mribble/CameraAxe6/Pcb/CA6_boms/BeamDetect_gerber/BOM_beamDetect.xlsx

Ref Des | Part Description | Qty Used | Link
J1 | RJ45 | 1 | http://www.mouser.com/ProductDetail/Amphenol-Commercial-Products/RJHSE-5080/
U3 | TSOP 38 Khz IR receiver | 1 | https://www.mouser.com/ProductDetail/Vishay-Semiconductors/TSOP38238/
R1 | 100 Ohm 0603 Resistor 1% | 1 | http://www.mouser.com/ProductDetail/Susumu/RR0816P-102-D/
C1 | 100 uF Electrolitic Cap | 1 | http://www.mouser.com/ProductDetail/Panasonic/EEE-1CA101WP/
C2 | 0.1 uF 0603 Cap | 1 | https://www.mouser.com/ProductDetail/Wurth-Electronics/885012206071
