mribble/CameraAxe6/Pcb/CA6_boms/BeamDetect_gerber/quote for  W138057ASC25 T-C16W138057A-3sets-BOM_beamDetect 2019-1-18 - 副本(1).xlsx

Ref Des | Part Description | Qty Used | Link | provided part NO. | Remarks
J1 | RJ45 | 1 | http://www.mouser.com/ProductDetail/Amphenol-Commercial-Products/RJHSE-5080/ | RJHSE-5080 | 5-7work days
U3 | TSOP 38 Khz IR receiver | 1 | https://www.mouser.com/ProductDetail/Vishay-Semiconductors/TSOP38238/ | TSOP38238
R1 | 100 Ohm 0603 Resistor 1% | 1 | http://www.mouser.com/ProductDetail/Susumu/RR0816P-102-D/ | RR0816P-102-D | 5-7work days
C1 | 100 uF Electrolitic Cap | 1 | http://www.mouser.com/ProductDetail/Panasonic/EEE-1CA101WP/ | EEE-1CA101WP | 5-7work days
C2 | 0.1 uF 0603 Cap | 1 | https://www.mouser.com/ProductDetail/Wurth-Electronics/885012206071 | 885012206071
