mribble/CameraAxe6/Pcb/CA6_boms/BeamEmit_gerber/BOM_beamEmit.xlsx

Ref Des | Part Description | Qty Used | Link
J1 | RJ45 | 1 | http://www.mouser.com/ProductDetail/Amphenol-Commercial-Products/RJHSE-5080/
Q1 | Mosfet | 1 | http://www.mouser.com/Search/ProductDetail.aspx
D1 D2 | 950 nm IR LED 100 mA | 2 | https://www.mouser.com/ProductDetail/Vishay-Semiconductors/TSAL6100/
R2 | 100K Ohm 0603 Resistor 1% | 1 | https://www.mouser.com/ProductDetail/Susumu/RR0816P-101-D/
R4 | 1K Ohm 0603 Resistor 1% | 1 | http://www.mouser.com/ProductDetail/Susumu/RR0816P-102-D/
R1 | 4.7 Ohm 1206 0.25W Resistor 1% | 1 | https://www.mouser.com/ProductDetail/Yageo/RC1206JR-074R7L?qs=sGAEpiMZZMtG0KNrPCHnjTtiZEI2zSDgLEynvoDfNGg%3d
C1 | 100 uF Electrolitic Cap | 1 | http://www.mouser.com/ProductDetail/Panasonic/EEE-1CA101WP/
C3 | 10 uF 1206 Cap | 1 | https://www.mouser.com/ProductDetail/Taiyo-Yuden/TMK316BJ106KL-T
C2 | 0.1 uF 0603 Cap | 1 | https://www.mouser.com/ProductDetail/Wurth-Electronics/885012206071
