mribble/CameraAxe6/Pcb/CA6_boms/CA6_gerber/BOM_ca6.xlsx

Ref Des | Part Description | Qty Used | Link
U16 | ATSAM3X8EA-AU | 1 | http://www.mouser.com/ProductDetail/Atmel/ATSAM3X8EA-AU/?qs=sGAEpiMZZMtQuSbTnHsVtm6dgCW59dFS
U4 | ESP-12F Module (4M Flash version) | 1 | http://www.electrodragon.com/product/esp-12f-esp8266-wifi-board/
C14 C17 C20 C24 C25 | 20 pF 0603 Cap | 5 | http://www.mouser.com/ProductDetail/Murata-Electronics/GRM1885C1H200JA01D/
C10 C11 C12 C13 C15 C19 C21 C22 C29 C3 C34 C35 C38 C39 C4 C40 C41 C8 | 0.1 uF 0603 Cap | 18 | https://www.mouser.com/ProductDetail/Wurth-Electronics/885012206071
C1 C16 C18 C2 C27 C28 C30 C31 C32 C33 C37 C42 C5 C9 | 10 uF 1206 Cap | 14 | https://www.mouser.com/ProductDetail/Taiyo-Yuden/TMK316BJ106KL-T
C23 C26 C6 C7 | 100 uF Electrolitic Cap | 4 | http://www.mouser.com/ProductDetail/Panasonic/EEE-1CA101WP/
R26 R27 | 39 Ohm 0603 Resistor 1% | 2 | http://www.mouser.com/ProductDetail/Susumu/RR0816Q-390-D/
R22 R23 R24 R30 R33 R34 R37 R38 R41 R42 R45 R46 R49 R50 R53 R54 R57 R58 | 274 Ohm 0603 Resistor 1% | 18 | https://www.mouser.com/ProductDetail/Yageo/RT0603FRE07274RL
R31 R32 R35 R36 R39 R40 R43 R44 R47 R48 R51 R52 R55 R56 R59 R60 | 680 Ohm 0603 Resistor 1% | 16 | http://www.mouser.com/ProductDetail/Susumu/RR0816P-681-D/
R62 R65 | 4k7 Ohm 0603 Resistor 1% | 2 | http://www.mouser.com/ProductDetail/Susumu/RR0816P-472-D/
R28 | 6K8 Ohm 0603 Resistor 1% | 1 | http://mouser.com/ProductDetail/Susumu/RR0816P-682-D/
R1 R10 R11 R12 R13 R14 R15 R16 R2 R21 R3 R4 R5 R6 R61 R63 R64 R66 R7 R8 R9 | 10K Ohm 0603 Resistor 1% | 21 | http://www.mouser.com/ProductDetail/Susumu/RR0816P-103-D/
R29 | 30K ohm 0603 Resistor 1% | 1 | http://www.mouser.com/ProductDetail/Susumu/RR0816P-303-D/
R17 R18 R19 R20 R25 | 100K Ohm 0603 Resistor 1% | 5 | http://www.mouser.com/ProductDetail/Susumu/RR0816P-104-D/
X7 | 12 Mhz Crystal | 1 | http://www.mouser.com/ProductDetail/ABRACON/ABM3B-12000MHZ-B2-T/
X8 | 32.786 KHz Crystal | 1 | http://www.mouser.com/ProductDetail/ABRACON/AB26TRQ-32768kHz-T/
VR1 VR2 VR3 | Varistor 0603 | 3 | http://www.mouser.com/ProductDetail/Bourns/CG0603MLC-05E/
F1 | resetable fuses 1812 (perfer 1.0 A hold, but 1.1A is ok) | 1 | http://www.mouser.com/ProductDetail/Littelfuse/MINISMDC110F-24-2/
FB1 FB2 FB3 | EMI Filter Beads 805 | 3 | http://www.mouser.com/ProductDetail/Bourns/MH2029-601Y/
D1 D2 D3 D4 D5 D6 D7 D8 D9 | Red/Green LED | 9 | http://www.mouser.com/ProductDetail/Kingbright/AM23ESGC/
SW4 | Through Hole Tactile Button | 1 | http://www.mouser.com/ProductDetail/CK-Components/PTS645SL70-2-LFS/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
SW1 SW3 | SMD Tactile Button PTS645 Series | 2 | https://www.mouser.com/Search/ProductDetail.aspx
SW2 | on/off switch 1A | 1 | http://www.mouser.com/ProductDetail/E-Switch/EG1224/
J1 | Micro USB type B | 1 | http://www.mouser.com/ProductDetail/FCI/10118194-0001LF/
CAM0 CAM1 CAM2 CAM3 CAM4 CAM5 CAM6 CAM7 | 3.5 mm jack (Camera Ports) (SJ-3523) | 8 | http://www.mouser.com/ProductDetail/CUI/SJ-3523-SMT-TR/
J2 | 2 3.5mm Screw Terminal | 1 | http://www.mouser.com/ProductDetail/Phoenix-Contact/1984617/
J3 J5 J4 J8 | RJ45 Module Socket | 4 | http://www.mouser.com/ProductDetail/Amphenol-Commercial-Products/RJHSE-5080/
J6 | 90 degree Expansion Port 50 PIN (2X25) | 1 | https://www.mouser.com/ProductDetail/3M-Electronic-Solutions-Division/30350-5002HB
Q1 Q10 Q11 Q12 Q13 Q14 Q15 Q16 Q2 Q3 Q4 Q5 Q6 Q7 Q8 Q9 | BSS138 Mosfet (Cam Ports) | 16 | http://www.mouser.com/ProductDetail/NXP-Semiconductors/BSS138P215/
P1 | jtag conector | 1 | http://www.mouser.com/Search/ProductDetail.aspx
U12 | 3.3V LDO Reg | 1 | http://www.mouser.com/ProductDetail/Texas-Instruments/LP38692MP-33-NOPB/?qs=sGAEpiMZZMvu8NZDyZ4K0c0kBHVNK554
U3 | 74AHC Buffer Chip | 2 | https://www.mouser.com/ProductDetail/Texas-Instruments/SN74LVC244APWR/
P3 | FTDI 6 Pin Header | 1 | http://www.mouser.com/ProductDetail/Molex/22-28-4060/
U1 U2 | 74AHC Logic-and | 1 | http://www.mouser.com/ProductDetail/Texas-Instruments/SN74AHC1G08DBVR/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
