mribble/CameraAxe6/Pcb/CA6_boms/Dev_gerber/BOM_dev.xlsx

Ref Des | Part Description | Qty Used | Link
J2 | RJ45 | 1 | http://www.mouser.com/ProductDetail/Amphenol-Commercial-Products/RJHSE-5080/
C1 | 10 uF 1206 Cap | 1 | https://www.mouser.com/ProductDetail/Taiyo-Yuden/TMK316BJ106KL-T
J1 | 3.5 mm jack (Camera Ports) (SJ-3523) | 1 | http://www.mouser.com/ProductDetail/CUI/SJ-3523-SMT-TR/
SW0 | SMD push switch | 1 | http://www.mouser.com/ProductDetail/CK-Components/PTS645SM43SMTR-92-LFS/
