mribble/CameraAxe6/Pcb/CA6_boms/Dev_gerber/quote for W138057ASC26-5sets-BOM_dev   2019-1-21.xlsx

Ref Des | Part Description | Qty Used | Link | provided part NO. | Remarks
J2 | RJ45 | 1 | http://www.mouser.com/ProductDetail/Amphenol-Commercial-Products/RJHSE-5080/ | RJHSE-5080 | 5-7work days
C1 | 10 uF 1206 Cap | 1 | https://www.mouser.com/ProductDetail/Taiyo-Yuden/TMK316BJ106KL-T | TMK316BJ106KL-T
J1 | 3.5 mm jack (Camera Ports) (SJ-3523) | 1 | http://www.mouser.com/ProductDetail/CUI/SJ-3523-SMT-TR/ | SJ-3523-SMT-TR | 5-7work days
SW0 | SMD push switch | 1 | http://www.mouser.com/ProductDetail/CK-Components/PTS645SM43SMTR-92-LFS/ | PTS645SM43SMTR92LFS | 5024pcs in stock
