mribble/CameraAxe6/Pcb/CA6_boms/Light_gerber/BOM_light.xlsx

Ref Des | Part Description | Qty Used | Link
J1 | RJ45 | 1 | http://www.mouser.com/ProductDetail/Amphenol-Commercial-Products/RJHSE-5080/
C2 | 100 uF Electrolitic Cap | 1 | http://www.mouser.com/ProductDetail/Panasonic/EEE-1CA101WP/
C1 | 10 uF 1206 Cap | 1 | https://www.mouser.com/ProductDetail/Taiyo-Yuden/TMK316BJ106KL-T
R3 | 160 Ohm 1206 Resistor 1/4W 1% | 1 | https://www.mouser.com/ProductDetail/Yageo/RT1206FRE07160RL/
R4 R2 R1 | 1K Ohm 0603 Resistor 1% | 3 | http://www.mouser.com/ProductDetail/Susumu/RR0816P-102-D/
R6 | 10K Ohm 0603 Resistor 1% | 1 | http://www.mouser.com/ProductDetail/Susumu/RR0816P-103-D/
R5 | 3.9k Ohm 0603 Resistor 1% | 1 | https://www.mouser.com/productdetail/susumu/rr0816p-392-d
R7 | 15k Ohm 0603 Resistor 1% | 1 | https://www.mouser.com/productdetail/susumu/rr0816p-153-d
U1 U2 U3 | SN74LVC1G07 Single Buffer/Driver | 3 | https://www.mouser.com/ProductDetail/Texas-Instruments/SN74LVC1G07DCKR/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
Q2 | Mosfet | 1 | http://www.mouser.com/Search/ProductDetail.aspx
J2 | 3.5 mm jack (Camera Ports) (SJ-3523) | 1 | http://www.mouser.com/ProductDetail/CUI/SJ-3523-SMT-TR/
