mribble/CameraAxe6/Pcb/CA6_boms/Light_gerber/quote for W138057ASC24-T-C19W138057A-5sets-BOM_light 2019-1-18 - 副本.xlsx

Ref Des | Part Description | Qty Used | Link | provided part NO. | Remarks
J1 | RJ45 | 1 | http://www.mouser.com/ProductDetail/Amphenol-Commercial-Products/RJHSE-5080/ | RJHSE-5080 | 5-7work days
C2 | 100 uF Electrolitic Cap | 1 | http://www.mouser.com/ProductDetail/Panasonic/EEE-1CA101WP/ | EEE-1CA101WP | 5-7work days
C1 | 10 uF 1206 Cap | 1 | https://www.mouser.com/ProductDetail/Taiyo-Yuden/TMK316BJ106KL-T | TMK316BJ106KL-T
R3 | 160 Ohm 1206 Resistor 1/4W 1% | 1 | https://www.mouser.com/ProductDetail/Yageo/RT1206FRE07160RL/ | RT1206FRE07160RL
R4 R2 R1 | 1K Ohm 0603 Resistor 1% | 3 | http://www.mouser.com/ProductDetail/Susumu/RR0816P-102-D/ | RR0816P-102-D | 5-7work days
R6 | 10K Ohm 0603 Resistor 1% | 1 | http://www.mouser.com/ProductDetail/Susumu/RR0816P-103-D/ | RR0816P-103-D | 5-7work days
R5 | 3.9k Ohm 0603 Resistor 1% | 1 | https://www.mouser.com/productdetail/susumu/rr0816p-392-d | RR0816P-392-D | 5-7work days
R7 | 15k Ohm 0603 Resistor 1% | 1 | https://www.mouser.com/productdetail/susumu/rr0816p-153-d | RR0816P-153-D | 5-7work days
U1 U2 U3 | SN74LVC1G07 Single Buffer/Driver | 3 | https://www.mouser.com/ProductDetail/Texas-Instruments/SN74LVC1G07DCKR/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 | SN74LVC1G07DCKR
Q2 | Mosfet | 1 | http://www.mouser.com/Search/ProductDetail.aspx | IRLML6244TRPBF
J2 | 3.5 mm jack (Camera Ports) (SJ-3523) | 1 | http://www.mouser.com/ProductDetail/CUI/SJ-3523-SMT-TR/ | SJ-3523-SMT-TR | 5-7work days
