mribble/CameraAxe6/Pcb/CA6_boms/Projectile_gerber/BOM_projectile.xlsx

Ref Des | Part Description | Qty Used | Link
J1 | RJ45 | 1 | http://www.mouser.com/ProductDetail/Amphenol-Commercial-Products/RJHSE-5080/
D2 D3 D4 D5 | 890 nm IR LED 100 mA | 4 | https://www.mouser.com/ProductDetail/Vishay-Semiconductors/TSHF5210/
Q1 Q2 | Mosfet | 2 | http://www.mouser.com/Search/ProductDetail.aspx
D1 D6 | IR Diode SFH213 FA | 2 | https://www.mouser.com/ProductDetail/OSRAM-Opto-Semiconductors/SFH-213-FA/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
U1 U2 | Opamp | 2 | https://www.mouser.com/ProductDetail/Texas-Instruments/OPA320AIDBVR/?qs=sGAEpiMZZMv2WiXdFcmpiKWA4h8Ns2XN
C4 C6 | 4.3 pF Cap C0G (NP0) 0805 | 2 | https://www.mouser.com/ProductDetail/AVX/08055A4R3DAQ2A/?qs=sGAEpiMZZMs0AnBnWHyRQKdiqyDPVQdAb6zdUloBn8k%3d
C2 | 0.1 uF 0603 Cap | 1 | https://www.mouser.com/ProductDetail/Wurth-Electronics/885012206071
C3 C5 | 1 uF 0603 Cap | 2 | https://www.mouser.com/ProductDetail/Wurth-Electronics/885012106022
C2 | 10 uF 1206 Cap | 1 | https://www.mouser.com/ProductDetail/Taiyo-Yuden/TMK316BJ106KL-T
R3 R11 | 280 Ohm 0603 Resistor 1% | 2 | https://www.mouser.com/ProductDetail/Yageo/RT0603DRD07280RL/
R5 R12 | 8980 Ohm 0603 Resistor 1% | 2 | https://www.mouser.com/ProductDetail/KOA-Speer/RN731JTTD8981D25/
R1 R2 R6 R8 R9 R10 | 49.9 ohm 0603 Resistor 1% | 6 | https://www.mouser.com/ProductDetail/Susumu/RR0816Q-49R9-D-68R/
R4 R16 | 1K Ohm 0603 Resistor 1% | 2 | http://www.mouser.com/ProductDetail/Susumu/RR0816P-102-D/
R14 R15 | 10K Ohm 0603 Resistor 1% | 2 | http://www.mouser.com/ProductDetail/Susumu/RR0816P-103-D/
R7 R13 | 100K Ohm 0603 Resistor 1% | 2 | https://www.mouser.com/ProductDetail/Susumu/RR0816P-101-D/
