mribble/CameraAxe6/Pcb/CA6_boms/Sound_gerber/BOM_sound.xlsx

Ref Des | Part Description | Qty Used | Link
J1 | RJ45 | 1 | http://www.mouser.com/ProductDetail/Amphenol-Commercial-Products/RJHSE-5080/
MK1 | Microphone Condenser | 1 | http://www.mouser.com/ProductDetail/CUI-Inc/CMA-4544PF-W/
U1 | Max 4466 Op Amp | 1 | http://www.mouser.com/ProductDetail/Maxim-Integrated/MAX4466EXK+T/?qs=sGAEpiMZZMuuBt6TL7D%2f6Dhq2AfIYa6Q
C4 | 47 pF 0603 Cap | 1 | http://www.mouser.com/ProductDetail/KEMET/C0603C470J1GACAUTO/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
C3 | 0.1 uF 0603 Cap | 1 | https://www.mouser.com/ProductDetail/Wurth-Electronics/885012206071
C2 | 1 uF 0603 Cap | 1 | https://www.mouser.com/ProductDetail/Wurth-Electronics/885012106022
C5 C1 | 47 uF 1206 Cap | 2 | http://www.mouser.com/ProductDetail/Taiyo-Yuden/LMK316BJ476ML-T/
R1 | 1K Ohm 0603 Resistor 1% | 1 | http://www.mouser.com/ProductDetail/Susumu/RR0816P-102-D/
R2 | 2.2K Ohm 0603 Resistor 1% | 1 | http://www.mouser.com/ProductDetail/Susumu/RR0816P-222-D/
R5 | 20K Ohm 0603 Resistor 1% | 1 | http://www.mouser.com/ProductDetail/Susumu/RR0816P-203-D/
R3 R4 | 100K Ohm 0603 Resistor 0.1% | 2 | http://www.mouser.com/ProductDetail/Panasonic/ERA-3AEB104V/?qs=sGAEpiMZZMu61qfTUdNhGxEjuuBLd0B4thhjUDN4FtU%3d
R6 | 1M Ohm 0603 Resistor 1% | 1 | http://www.mouser.com/ProductDetail/TE-Connectivity-Neohm/CPF0603B1M0E1/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
