mribble/CameraAxe6/Pcb/CA6_boms/Valve_gerber/BOM_valve.xlsx

Ref Des | Part Description | Qty Used | Link
J1 | RJ45 | 1 | http://www.mouser.com/ProductDetail/Amphenol-Commercial-Products/RJHSE-5080/
Q1 Q2 Q3 Q4 | Motor Mosfet | 4 | http://www.mouser.com/Search/ProductDetail.aspx
D1 D2 D3 D4 | Diode | 4 | http://www.mouser.com/ProductDetail/Vishay-Semiconductors/S07G-GS08/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
C1 | 10 uF 1206 Cap | 1 | https://www.mouser.com/ProductDetail/Taiyo-Yuden/TMK316BJ106KL-T
C2 | 100 uF Electrolitic Cap | 1 | http://www.mouser.com/ProductDetail/Panasonic/EEE-1CA101WP/
Servo1 Servo2 | Servo Terminal | 2 | http://www.mouser.com/ProductDetail/FCI/68016-403HLF/
POWER1 | DC Jack 2.1 x 5.51 mm (Power) | 1 | http://www.digikey.com/product-detail/en/PJ-002A/CP-002A-ND/96962
Valve1 Valve2 Valve3 Valve4 | DC Jack 1.3 x 3.5 mm (Valves) | 4 | http://www.mouser.com/ProductDetail/CUI/PJ-017DH/
R1 R3 R5 R7 R9 | 1K Ohm 0603 Resistor 1% | 5 | http://www.mouser.com/ProductDetail/Susumu/RR0816P-102-D/
R2 R4 R6 R8 | 10K Ohm 0603 Resistor 1% | 4 | http://www.mouser.com/ProductDetail/Susumu/RR0816P-103-D/
D5 | Green LED 0805 | 1 | https://www.mouser.com/ProductDetail/OSRAM-Opto-Semiconductors/LG-R971
