mribble/CameraAxe6/Pcb/CA6_boms/Vibration_gerber/quote for W138057ASC30-5sets-BOM_vibration 2019-1-20.xlsx

Part Description | Ref Des | Part Description | Qty Used | Link | provided part NO. | Remarks
RJ45 | J1 | RJ45 | 1 | http://www.mouser.com/ProductDetail/Amphenol-Commercial-Products/RJHSE-5080/ | RJHSE-5080 | 5-7work days
1M Ohm 0603 Resistor | R1 | 0603 1M Ohm Resistor | 1 | http://www.mouser.com/ProductDetail/Bourns/CRT0603-DZ-1004ELF/ | CRT0603-DZ-1004ELF | 5-7work days
Zener Diode sot23 | D1 | 3.3V Zener Diode | 1 | http://www.mouser.com/ProductDetail/Rectron/BZX84C3V3-T1/ | BZX84C3V3-T1 | 5-7work days
