mribble/CameraAxe6/Case/module_plate v15.stl

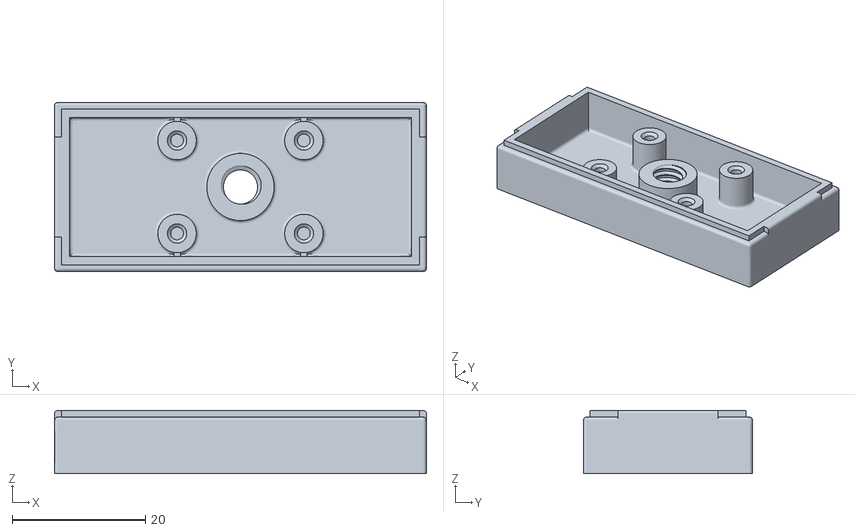
[picture p1: CAD file, 2019-04-10]
Case/module_plate v15.stl
55.9 x 25.4 x 9.50
