mribble/CameraAxe6/Case/module_plate_top v8.stl

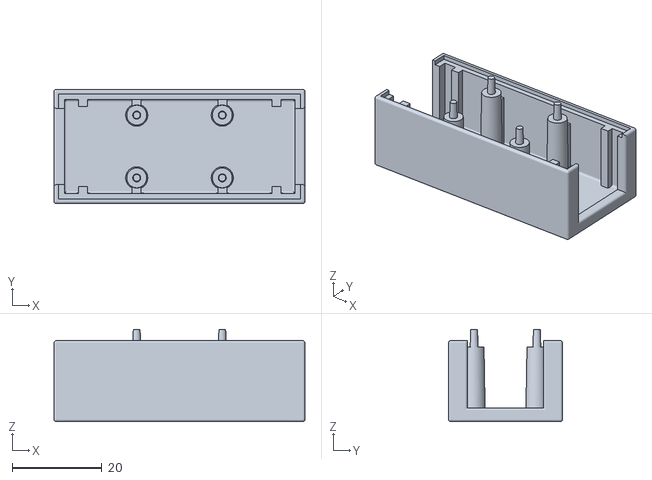
[picture p2: CAD file, 2019-04-10]
Case/module_plate_top v8.stl
55.9 x 25.4 x 20.5
