mribble/CameraAxe6/Case/Battery Cover v11.stl

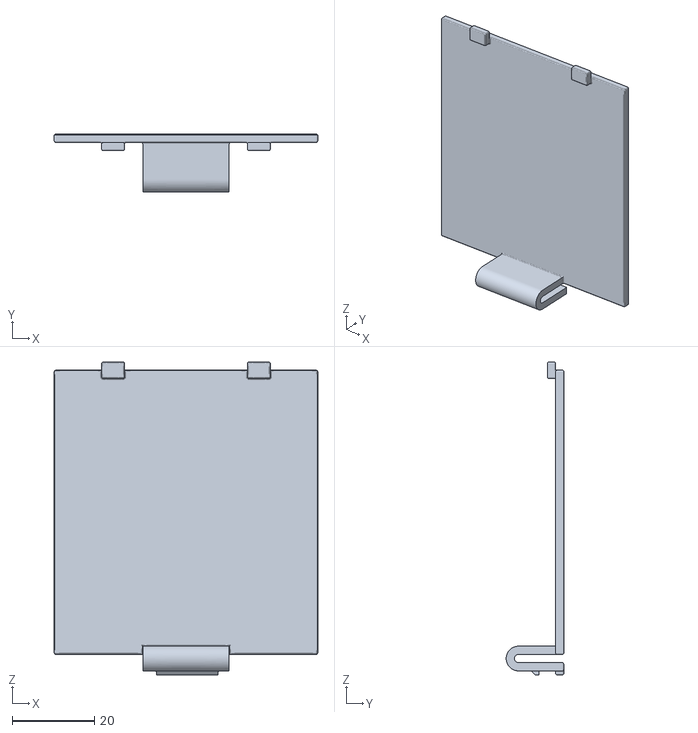
[picture p3: CAD file, 2019-04-10]
Case/Battery Cover v11.stl
64.0 x 14.0 x 76.0
