mribble/CameraAxe6/Case/Battery Cover Tight Fit v2.stl

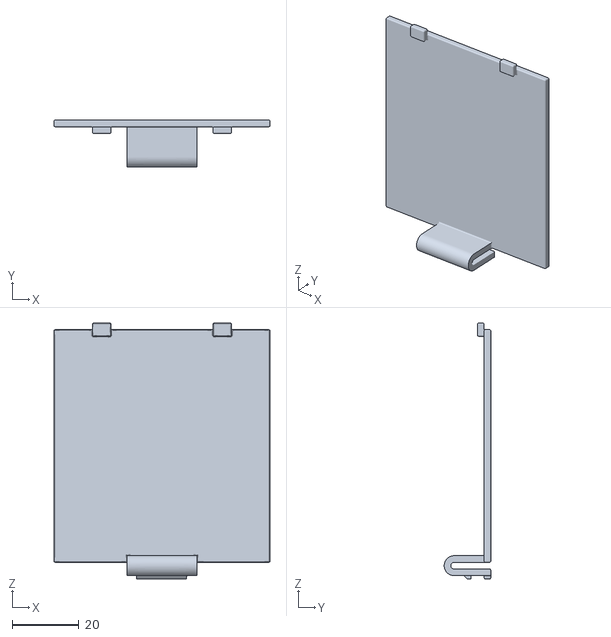
[picture p4: CAD file, 2019-04-10]
Case/Battery Cover Tight Fit v2.stl
64.8 x 14.0 x 76.8
