mribble/CameraAxe6/Case/CA6 Top Half.stl

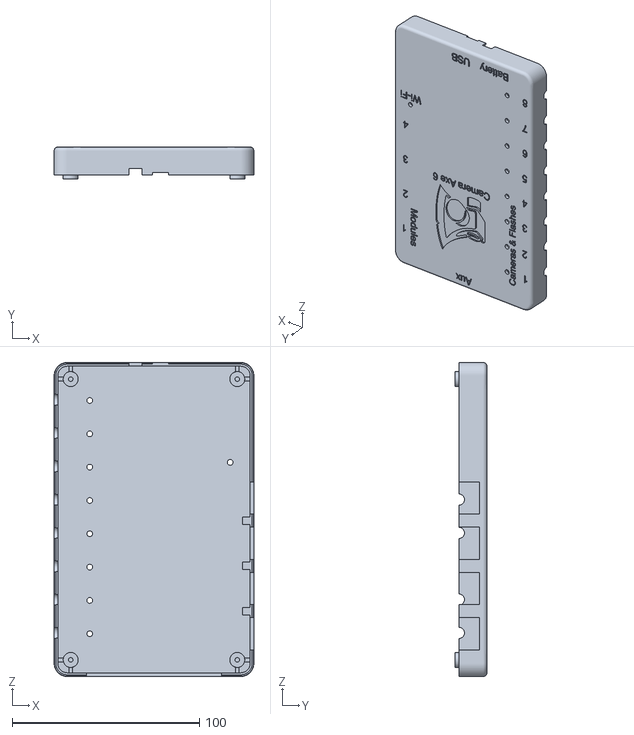
[picture p5: CAD file, 2019-04-10]
Case/CA6 Top Half.stl
106.6 x 17.0 x 167.6
