mribble/CameraAxe6/Case/CA6 Bottom Half.stl

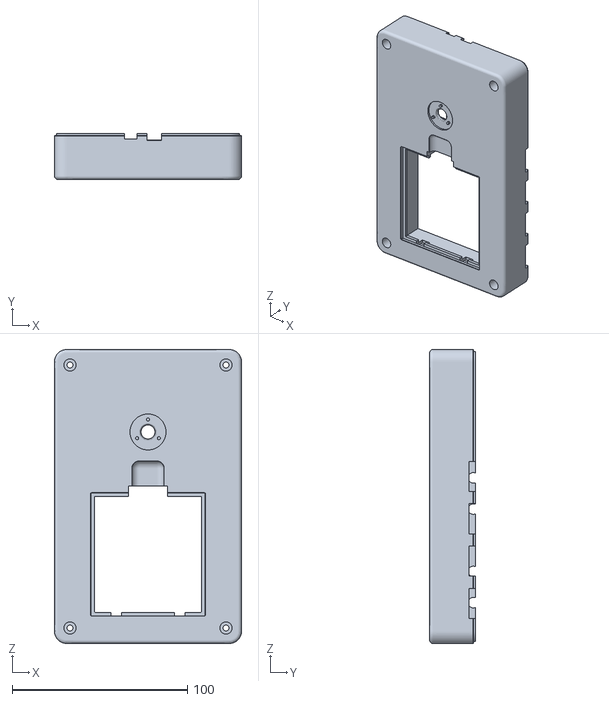
[picture p6: CAD file, 2019-04-10]
Case/CA6 Bottom Half.stl
106.6 x 26.2 x 167.6
