mribble/CameraAxe6/CameraAxeFlash/Spice/CameraAxeFlash.asc

A1: and; Vhigh=5
A2: srflop; Vhigh=5, ic=0, Ref=2.5, Td=10n
B1: bv; V=if(V(VT0)<2.9, 5, 0) ; V Limit
B2: bv; V=if(I(R3)<0.1, 5, 0) ; Flux Reset
B3: bv; V=if(I(R3)>2, 5, 0) ; Max I current
C1: polcap; 10µ; V=250 Rser=100m Lser=0
C2: cap; 0.1µ
C3: cap; 0.1µ
C4: cap; 0.1µ
D1: schottky; RB058L150
D2: LED; CMA255072WHT
D3: LED; MH-BWHT
L1: ind; 100µ; Ipk=3 Rser=180m Rpar=0 Cpar=0
L2: ind; 20n
M1: nmos; IRFP250N
M2: nmos; irfs4227pbf
R1: res; 1Meg
R2: res; 20K
R3: res; 1
R4: res; 100
R5: res; 10K
V1: voltage; 12
V2: voltage; PULSE(0 12 .12 0 0 50u)
V3: voltage; PULSE(0 5 0 0 0 18u 58u)
Named nets: 0, VT0
.tran 0 .15 0
C1 scaled /10
to reduce simulation time
Voltage logic, and gate, and flipflop all simulated by microcontroller
.lib CMA3090-72VSpice.txt
.lib irfs4227pbf.spi
.lib TC4420_I2D_B.mod
.lib XLamp-MHB-Spice.txt
