mribble/CameraAxe6/(list of files, drawings)

Other design files:
Pcb/CA6.dsn
Pcb/Cards/ESP8266card.dsn
Pcb/Cards/nRF52card.dsn
Pcb/Modules/Dev/Dev.dsn
Pcb/Modules/Sound/Sound.dsn
Pcb/Modules/Valve/Valve.dsn
