mribble/CameraAxe6/Sam3x/CA6/CA6.ino

////////////////////////////////////////////////////////////////////////////////////////////////////////////////////////
// Maurice Ribble
// Dreaming Robots - Copyright 2017, 2018
//
// This runs the Camera Axe 6 (CA6) software on an sam3x microcontroller.  The primary purposes of this software are
// to communicate with the esp8266 wifi module, monitor modules, and trigger cameras/flashes as requested.
//
// 2018.1.18
//   - Initial version
////////////////////////////////////////////////////////////////////////////////////////////////////////////////////////

#include <CAPacket.h>
#include <CAPacketHelper.h>
#include <CAEsp8266.h>
#include "Context.h"
#include "Menus.h"
#include "NewMenu.h"
#include "PacketProcessor.h"
#include "Terminal.h"
#include "Tests.h"
#include "TriggerCam.h"

// Global Context
Context g_ctx;
String gSamVersion = "sam180721";

void setup() {
  // Set up clock ticks
  *REG_SCB_DEMCR |= 0x01000000;
  *REG_DWT_CTRL |= (uint32_t)1;
  *REG_DWT_CYCCNT = (uint32_t)0;

  // When CC_EXT0 is high it forces the esp8266 into test mode
  hwPortPin ppExt0 = CAU::getOnboardDevicePin(CC_EXT0);
  CAU::pinMode(ppExt0, OUTPUT);
  CAU::digitalWrite(ppExt0, LOW);

  initCameraPins();
  SerialIO.begin(12345); // Speed doesn't matter here
  CAU::initializeAnalog();
  g_ctx.esp8266.init(74880);
  g_ctx.packetHelper.init(g_ctx.esp8266.getSerial(), (HardwareSerial*)(&SerialIO));
  hwPortPin ppVoltage = CAU::getOnboardDevicePin(LV_DETECT_PIN);
  CAU::pinMode(ppVoltage, ANALOG_INPUT);
  caRunTests();
  esp8266ProgramMode();
}

void loop() {
  uint32_t periodDataTime = 0;
  while(1) { // Existing loop causes 10 ms delay so we will stay in it forever to avoid that delay
    processTerminalCmds();

    if (g_ctx.state == CA_STATE_MENU_MODE) {
      if (g_ctx.menuId == 0) {
        // Menus normally process packets, but menuId is a null menu which means we need to handle the processing here
        CAPacketElement *packet = processIncomingPacket();
        if (packet) {
          delete packet;
        }
      } else {
        g_ctx.procTable.funcMenuRun[g_ctx.menuId]();
      }
      if (!camTriggerRunning()) {
        // This needs to get turned off for test trigger and there wasn't a better spot
        resetCameraPorts();
      }
      if ((millis() - periodDataTime) >= 20000) {  // Send periodic data every 20 seconds
        g_ctx.packetHelper.writePacketPeriodicData(getHundredthsOfVoltsAtBattery(), gSamVersion.c_str());
        periodDataTime = millis();
      }
    } else if (g_ctx.state == CA_STATE_PHOTO_MODE) {
      g_ctx.procTable.funcPhotoRun[g_ctx.menuId]();
    } else {
      CA_ASSERT(0, "Unsupported CA_STATE mode");
    }
  }
}

// Get the current voltage
uint32_t getHundredthsOfVoltsAtBattery() {
  hwPortPin ppVoltage = CAU::getOnboardDevicePin(LV_DETECT_PIN);
  uint32_t voltage = CAU::analogRead(ppVoltage);
  // Convert to hundredths of volts by multiplying by max max voltage (4096 is from 12 bit ADC on sam3x)
  // (3.3 * 4 * 100)=1320 [3.3 is voltage; 4x voltage divider circuit; 100 is to make hundredths of volts]
  voltage = voltage * 1320 / 4096;
  return voltage;  
}

// Put esp8266 into programming mode if dev module on port 4 button pressed during boot
void esp8266ProgramMode() {
  hwPortPin ppPin;
  ppPin = CAU::getOnboardDevicePin(PROG_BUTTON);
  CAU::pinMode(ppPin, INPUT_PULLUP);
  if (CAU::digitalRead(ppPin) == LOW) {
    CA_LOG(CA_INFO, "Sam3x passthrough ESP8266 reprogramming mode, cycle power when finished\n");
    g_ctx.esp8266.end();
    g_ctx.esp8266.init(115200);
    g_ctx.esp8266.reprogramESP();
    g_ctx.packetHelper.flushGarbagePackets();
    blinkCameraPins();

    HardwareSerial *s = g_ctx.esp8266.getSerial();
    // Setup serial passthrough.  Must use power switch after programming is complete
    while (1) {
      if(SerialIO.available()){
        s->write(SerialIO.read());
      }
      if(s->available()){
        SerialIO.write(s->read());
      }
    }
  }
}
