mribble/CameraAxe6/(commit log)

2017-01-03 Fix some bugs in packet code and clean up tests
    [Tests.ino]
2017-01-04 A bug in the tests were hiding several bugs in the packet classes. Fixed all known bugs in this code.
    [Tests.ino]
2017-01-04 Add button packet. Previously the button didn't have any text so that was added.
    [Tests.ino]
2017-01-05 Add DROP_SELECT packet. Also realized I was forgetting to copy over the lib changes for the past serveral commits so the builds were broken. This should fix that.
    [Tests.ino]
2017-01-07 Add Button and CheckBox packets to Android
2017-01-09 Update module and camera code to use new packet data. (More work needed)
2017-01-12 Add packet reset and a packet handler on the sam3x side
    [CA6.ino, Context.h, PacketProcessor.ino, Tests.ino]
2017-01-12 Change ACTIVATE packet to MENU_SELECT and add more info to it. Also added packet reset to Android to keep classes in sync
    [PacketProcessor.ino, Tests.ino]
2017-01-13 Get sending and receiving packets kind of working between android and sam3x. There is a bug where a lot of the messages from esp8266 are not received by android so that needs to be investigated.
    [CA6.ino, Esp8266.ino, PacketProcessor.ino, Tests.ino]
2017-01-14 Fix reliability issue by making sure the ports were correct all the time
    [Esp8266.ino]
2017-01-16 Seperated the send and receive threads on Android
2017-01-22 Add PCB files for new version of kicad
    [CA6-B.Cu.gbl, CA6-B.Mask.gbs, CA6-B.Paste.gbp, CA6-B.SilkS.gbo, CA6-Edge.Cuts.gm1, CA6-F.Cu.gtl, CA6-F.Mask.gts, CA6-F.Paste.gtp]
2017-01-23 add missing pcb files
2017-01-27 Added ESP8266 programming mode, reset, and rudimentary command processor. A few lines added to ca6.ino, the rest in CA6_Esp class and in processCommand.ino
    [CA6.ino]
2017-01-27 Reworked packets interface. Now each packet represents a line in the menu (more or less)
    [CA6.ino, PacketProcessor.ino, Tests.ino]
2017-01-29 Fix some bugs with the 2 byte size in packets. Things are working again
    [Esp8266.ino, PacketProcessor.ino]
2017-01-30 Switch Menu/Active to a single file. Add a new test packet with all the different packet types that need testing
2017-01-31 Fix text_dynamic to have both static and dynamic field, and add that packet to menu display
    [PacketProcessor.ino, Tests.ino]
2017-01-31 Add a little debug logging to threads
2017-02-01 Move threads and adapter into a retained fragment so the app handles rotations
2017-02-02 ESP8266 reprogram, reset, command proc., merged with Maurice's 2/1 code. Commands include 'p'-program ESP8266; 'r'-reset ESP8266; 'b'-future bluetooth pairing. While I thought I had captured all prog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
    [CA6.ino, Esp8266.ino]
2017-02-02 Make text dynamic send back a new value every 500 ms. It worked, but disabled due to other issues this exposed
    [CA6.ino, Context.h, PacketProcessor.ino]
2017-02-03 Clean up code. Fix bug with junk packets
    [CA6.ino, Context.h, Terminal.ino]
2017-02-05 Enable and fix the module checking eeprom code
    [CA6.ino, Terminal.ino]
2017-02-06 Switch over to single menu instead of a menu per module
2017-02-06 Remove interModuleLogic packets which are no longer needed
    [PacketProcessor.ino, Tests.ino]
2017-02-12 Fix bugs in packet handling (size and interrupt issue)
    [CA6.ino]
2017-02-13 Fix bug with sound menu that was preventing updates
    [PacketProcessor.ino]
2017-02-14 Switch from using an adapter for the dynamic menu to using a scroll list and linearLayout. There were lots of little issues with how the constant updating of the dynamic list was causing issues. Whil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
2017-02-15 Fix bug in packet handler where size clamped to 8 bits. Changed packet classes to be derived from CAPacketElement so that we could return packet pointers to process packets in menus. Added code to pr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
    [CA6.ino, MenuData.h, PacketProcessor.ino]
2017-02-15 Fix some bugs and finish implementing the two menus.
    [CA6.ino, MenuData.h, PacketProcessor.ino]
2017-02-16 Add camera settings to the UI (with swipe control). UI works, but it doesn't do anything yet.
2017-02-17 Fill in camera settings spinner
2017-02-18 Setup framework for passing data back from the CameraSettingsActivity to the MainActivity
2017-02-20 Pass actual packet data from the camera activity to the main activity (instead of test strings). However it still isn't the correct data yet.
2017-02-21 Pass camera settings packet from Android to sam3x. Some packets get corrupted when sending a bunch at the same time (probably due to UDP instead of TCP which I need to fix). The timebox values are fo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
2017-02-24 Several small fixes. 1) Update Android SDK version. 2) Clean up serial port handling to be in ESP class instead of packet handling class. 3) Add serial passthrough mode to terminal to help with testi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
    [CA6.ino, Terminal.ino, Tests.ino]
2017-02-28 Add a passthrough BLE path for nRF52 board
2017-03-01 Fix footprint library issue
2017-03-01 Remove some bad conversion artifacts from pcb
    [CA6.kicad_pcb]
2017-03-02 Fix switch and battery footprints to remove errors when importing a new netlist
2017-03-02 Hide a bunnch of labels we don't want to see in the schematic
    [CA6.sch]
2017-03-03 Clear out old traces and make it a 2 layer board
    [CA6.sch]
2017-03-04 Remove link port, only support 3.3V on aux, make board bigger, make board 2 layers, add camera port leds
    [CA6.dsn, CA6.kicad_pcb, CA6.sch]
2017-03-04 Lots more small changes to the pcb
    [CA6.kicad_pcb, CA6.sch]
2017-03-05 Clean up layout and add ground plane
    [CA6.dsn, CA6.kicad_pcb, CA6.sch]
2017-03-05 Replace WiFiManager with my fork of the library, with 2 enhancements: 1. Add "Exit" button to HTML screen to allow user to exit without connecting to a local network, thus defaulting to AP mode. THis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
2017-03-05 Minor cleanup
    [CA6.dsn, CA6.kicad_pcb]
2017-03-05 Initial checkin of rewritten ESP8266 init code. 1. Remove old defines with different modes 2. Use WiFiManager to establish the IP address, allowing for use on a local WiFi network as well as "standal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
2017-03-05 Add more traces
    [CA6.dsn, CA6.kicad_pcb]
2017-03-06 Routing pcb
    [CA6.dsn, CA6.kicad_pcb, CA6.sch, CA6_2.kicad_pcb]
2017-03-07 More updates on pcb layout
    [CA6.dsn, CA6.kicad_pcb, CA6.sch, CA6_2.kicad_pcb]
2017-03-08 Another layout of the pcb
    [CA6.dsn, CA6.kicad_pcb, CA6.sch, CA6_2.kicad_pcb]
2017-03-10 Check in pcb files
    [CA6.dsn, CA6.kicad_pcb, CA6.sch, CA6_2.kicad_pcb]
2017-03-10 Clean up file names for pcb
    [CA6.kicad_pcb, CA6_0.kicad_pcb, CA6_2.kicad_pcb]
2017-03-10 Remove old pcb files
    [CA6-B_Cu.gbl, CA6-B_Mask.gbs, CA6-B_Paste.gbp, CA6-B_SilkS.gbo, CA6-Edge_Cuts.gbr, CA6-F_Cu.gtl, CA6-F_Mask.gts, CA6-F_Paste.gtp]
2017-03-10 Moving files around
    [CA6-B.Cu.gbl, CA6-B.Mask.gbs, CA6-B.Paste.gbp, CA6-B.SilkS.gbo, CA6-Edge.Cuts.gm1, CA6-F.Cu.gtl, CA6-F.Mask.gts, CA6-F.Paste.gtp]
2017-03-10 Update gerbers and remove logo off back of pcb
    [CA6-B.Cu.gbl, CA6-B.Mask.gbs, CA6-B.Paste.gbp, CA6-B.SilkS.gbo, CA6-Edge.Cuts.gm1, CA6-F.Cu.gtl, CA6-F.Mask.gts, CA6-F.Paste.gtp]
2017-03-10 Check in first version of dev module
    [Dev.kicad_pcb, Dev.sch]
2017-03-11 ESP8266 card first checkin NOT COMPLETE - Schematic good (Note: left out 1K on ESP-RX); Board should have good footprints, but layout incomplete. Checking in for discussion. May want to flip ESP-12F 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
    [ESP8266card.kicad_pcb, ESP8266card.sch]
2017-03-11 1st commit with completed schematic and routed board. Added 1K on ESP RX back in (easy to short later if it causes problems). Used 12 mil Power & Gnd and 6 mil remaining traces. 1x10 CA6_Com_connecto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
    [ESP8266card.kicad_pcb, ESP8266card.sch]
2017-03-11 Fix some drc issues
    [ESP8266card.sch]
2017-03-12 Eliminated ground pour, changed FTDI headers to angled, corrected ESP-12E/F-no-bottom-pads to SMD pads, improved spacing near antenna, moved and shrank some text values
    [ESP8266card.kicad_pcb, ESP8266card.sch]
2017-03-12 Rework card pcb. Labeled more parts. Moved parts around. Ran traces.
    [ESP8266card.dsn, ESP8266card.kicad_pcb]
2017-03-12 Rework dev board layout so both parts are on same side of the case
    [Dev.dsn, Dev.kicad_pcb]
2017-03-13 NOTE: the serial communication with the SAM3x does NOT WORK if DEBUG is defined. Still need to look into this - I suspect the SoftwareSerial library and some odd intreaction with the hw UART. Will co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
    [Esp8266.ino]
2017-03-13 1. Remove wifi credentials reset via pin - do this with the utility now instead 2. Add essential status messages printed to Serial even with DEBUG off (in setup() ONLY) 3. Use new WiFi Manager lib wi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
    [Esp8266.ino]
2017-03-14 Major restructuring. 1. Initiatization is now done via a state machine in loop() using separate functions vs all init in setup() 2. Client data structure created to better organize the vars, but also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
2017-03-14 Add first drop of BLE code (currently disabled)
2017-03-14 Revert "Major restructuring."
    This reverts commit 33b35540dd0922e2e79e94a23be150778dff4af0.
    [Esp8266.ino]
2017-03-14 Major restructuring. 1. Initiatization is now done via a state machine in loop() using separate functions vs all init in setup() 2. Client data structure created to better organize the vars, but also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
    CODING CHANGES ONLY - NO DEBUG
2017-03-14 Add SKIP_CLIENT_ACK define to switch between normal ACKs and simulating one for testing
    [Esp8266.ino]
2017-03-15 Fix an important typo.
    [Esp8266.ino]
2017-03-15 Change blinking modes: - alternating red/green blink while in wifi manager config screens - slow green blink awaiting client connection (STA mode) - fast green blink awaiting client connection (AP mo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
    Need to test with an RBG LED also. TODO.
2017-03-16 Cannot blink the LEDs until after we return from connectToNetwork() - timer.run not being called.
2017-03-16 Remove broken SoftwareSerial and use ESP Serial1 (UART1/GPIO2) instead. No Rx, but we don't need that anyway.
    [Esp8266.ino]
2017-03-17 1. Use ESP os_timer SDK function instead of SimpleTimer so we can blink even if timer.run is not being called. 2. Remove fixed blink intervals and replace with an optional parameter to setState to sp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
    [Esp8266.ino]
2017-03-17 Pick up edits missed in the last commit
    [Esp8266.ino]
2017-03-17 Started schematic for updated ESP8266 card with AND gate. Have text fields with decisions TBD. For discussion.
    [ESP8266card2.kicad_pcb, ESP8266card2.sch]
2017-03-18 Use new WiFi manager function to set the label on the config portal Exit button to clarify the user interface/process
2017-03-18 Copy in new WiFi Manager library with the function to set th Exit button label
2017-03-19 Update readme for new function to set Exit button label
2017-03-19 Minor edits while doing systems test.
    *** test results ***
    Tested ok: wifi address establishment (AP & STA modes), LED status lights, debug console I/O, auto-discovery (with standalone client only), packet handling (input & output).
    Also, all utilities test OK
2017-03-19 Turn off the connection status LED 30 seconds after a connection is established
2017-03-20 Get BLE partially working (still fails when too much data comes too fast like on test menu).
    [Esp8266.ino]
2017-03-20 Pick up Maurice's fix in esp8266.ino
    [Esp8266.ino]
2017-03-21 Switch to the standard integer type definitions.
2017-03-22 1. Replace events using SimpleTimer with the SDK OS timer, which is now the single timer mechanism in use 2. rename SKIP_CLIENT_ACK to SIMULATE_CLIENT_ACK for clarity
    [Esp8266.ino]
2017-03-22 Latest NetDiscovery update. This version requires the device's IP address to be passed to begin(). This enables correct operation in both AP and STA modes.
    [ADClientStub.ino, Esp8266.ino]
2017-03-22 Replace DEBUG_MSG with 3 macros to better conform to CA convenstions. New macros are:
    CA_INFO - informational debug messages
    CA_ERROR - debug error messages
    CA_ASSERT - general assertion macro
    The definitions have also now been moved into a common header file/library
    [ADClientStub.ino, Esp8266.ino]
2017-03-22 Disable interrupts within the autoDiscovery function
2017-03-23 1. Create a new common library/header file, CAStd.h that can be applied to botht he SAM3x and the ESP8266 code. 2. Modify ESP8266 sketch to use this header file, which replaces CAEsp8266Debug (which 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
    [Esp8266.ino]
2017-03-23 Finish migration to CAStd.h. Change auto-discovery messages to use debug macros instead of printing directly to the console Disable CA_DEBUG & ESP_ALT_CONSOLE
2017-03-25 Slower rate between sam3x and connection cards to 4800 baud. And add in a software serial flow control hack (currently disabled).
2017-03-27 Update card header to have 2 more pins -- now a 6x2 header
    [CA6-B.Cu.gbl, CA6-B.Mask.gbs, CA6-Edge.Cuts.gm1, CA6-F.Cu.gtl, CA6-F.Mask.gts, CA6-F.Paste.gtp, CA6-F.SilkS.gto, CA6-NPTH.drl]
2017-03-27 Partial changes to ESP8266card2 before merge with updated CA6 main board for 2x6 header, etc.
    [ESP8266card2.sch]
2017-03-28 Temp commit to check and update dimensions between CA6 board and connection card
    [ESP8266card2.kicad_pcb, ESP8266card2.sch]
2017-03-30 Almost complete ESP8266card2. Schematic updated with logic gate, removed 1k resistors, updated 2 pull-ups to 4.7k; Board has 2x6 pin connector to CA6 and stability screw. Board routed, needs some cle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
    [ESP8266card2.dsn, ESP8266card2.kicad_pcb, ESP8266card2.sch]
2017-04-01 Corrected ESP8266card2 for AND gate pins, routing and text. Added first version of nRF52card. Put all components in CA6.lib and CA6.pretty Still needs checking expecially for text.
    [ESP8266card2.dsn, ESP8266card2.kicad_pcb, ESP8266card2.sch, nRF52card.dsn, nRF52card.kicad_pcb, nRF52card.sch]
2017-04-01 Got rid of old 1x10 version and renamed cards2 to card, also fixed one text field
    [ESP8266card.dsn, ESP8266card.kicad_pcb, ESP8266card.sch, ESP8266card2.dsn, ESP8266card2.kicad_pcb, ESP8266card2.sch]
2017-04-01 Updated all text on both ESP8266card and nRF52card to minimum of .635x.635x.1524 (6 mils). Verified that all pins chosen on nRF52 can be used as general IO if we're not using smartBasic (which we pro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
    [ESP8266card.kicad_pcb, nRF52card.kicad_pcb, nRF52card.sch]
2017-04-02 corrected labelling of EXT pins on both nRF52card and ESP8266card and rerouted some traces on nRF52card for better ground pour.
    [ESP8266card.kicad_pcb, ESP8266card.sch, nRF52card.kicad_pcb, nRF52card.sch]
2017-04-02 Significant changes to the layout of the ESP8266card to allow a good ground pour.
    [ESP8266card.dsn, ESP8266card.kicad_pcb]
2017-04-03 Change clearance from 10 mil to 9 mil for thicker traces. Fixes some DRC errors
    [nRF52card.kicad_pcb]
2017-04-03 Give module rounded corners
    [Dev.kicad_pcb]
2017-04-05 Add gerbers
    [CA6-B.Cu.gbl, CA6-B.Mask.gbs, CA6-Edge.Cuts.gm1, CA6-F.Cu.gtl, CA6-F.Mask.gts, CA6-F.Paste.gtp, CA6-F.SilkS.gto, CA6-NPTH.drl]
2017-04-06 Switch to using the *_t int types, and the new logging in CAStd.h (lots of syntax changes, but few functional changes). I still have an open question for the new logging that needs to be answered.
2017-04-11 Add new footprints for rj45 and switch
    [CA6-B.Cu.gbl, CA6-B.Mask.gbs, CA6-Edge.Cuts.gm1, CA6-F.Cu.gtl, CA6-F.Mask.gts, CA6-F.Paste.gtp, CA6-F.SilkS.gto, CA6-NPTH.drl]
2017-04-12 Adjust switch. Fix top mask issue
    [CA6-B.Cu.gbl, CA6-B.Mask.gbs, CA6-Edge.Cuts.gm1, CA6-F.Cu.gtl, CA6-F.Mask.gts, CA6-F.Paste.gtp, CA6-F.SilkS.gto, CA6-NPTH.drl]
2017-04-13 Adjust switch layout one more time.
    [CA6-B.Cu.gbl, CA6-B.Mask.gbs, CA6-Edge.Cuts.gm1, CA6-F.Cu.gtl, CA6-F.Mask.gts, CA6-F.Paste.gtp, CA6-F.SilkS.gto, CA6-NPTH.drl]
2017-05-04 Switch to using tables for a more descriptive layout. And start setting up code for ajax scripts.
2017-05-24 Switch to using javascript to generate menus
2017-06-21 Remove a bunch of files no longer needed for the web_server approach
    [ADClientStub.ino, ClearCredentials.ino, Esp8266.ino]
2017-07-20 Rework the packets meet the new website architecture
    [CA6.ino, PacketProcessor.ino, Tests.ino]
2017-08-04 Update code to work with v4 PCB (and fix a few bugs)
    [Esp8266.ino, Tests.ino]
2017-08-16 Change to using buffered loads of files. This fixes some memory issues I was seeing
    [Esp8266.ino]
2017-08-16 Cleanup esp8266 code. Code will be getting more complicated soon as we start adding more complex parsing and packet code to this device
2017-08-17 Add flash side to debug info. Move html pages around. Fixed some of the pages to generate packets.
    [Esp8266.ino]
2017-08-19 Fix some issues in assert so packet class compiles on esp8266. There seems to be a slight difference in the P macro for sam3x and esp8266. It doesn't really matter because that macro is actually only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
    [Esp8266.ino]
2017-08-21 Fix some bugs with packet handling. Get a single packet passing from JS->esp8266->sam3x
    [PacketProcessor.ino, Tests.ino]
2017-08-22 Starting using packetHelper on esp8266. Changed the packetFromString() name to an overloaded set(). Removed CAPacketCamSettingBase since it was a pain and not saving us much. Fixed a guardFound bug.
    [Context.h, Esp8266.ino, PacketProcessor.ino, Tests.ino]
2017-08-22 Put in framework for sending packets from ESP8266 to sam3x
2017-08-29 Update packets to meet current needs. Removed flag bits from string, uint32, and timebox packets. Changed menu select from using a number to using a string as the id.
2017-08-30 Properly switch menus on sam3x when menus change on webpage
2017-08-30 Move inner loop into photo loop for real menus to reduce latency -- Arduino has a 10ms idle in it's loop
2017-08-31 Add new LED control class and hook it up to the esp8266. Now the LED is red if not connected. Blinking orange when connected to AP. Blinking green when connected to STA.
2017-08-31 Switch timebox to using less fields (just seconds and nanoseconds). Fix bug in JS where number validation was being skipped.
    [PacketProcessor.ino, Tests.ino]
2017-09-03 Update the camera settings page to have the correct options.
2017-09-03 Hook the camera Setup packet to send data to the sam3x.
2017-09-04 Rework dynamic menus so they use a form and submit all packets at once. This is needed for saving/restoring menu settings and is cleaner.
    [CA6.ino, PacketProcessor.ino]
2017-09-07 Clean up HTML page. Also fix bug in loading files over 32K.
    [helper.ino]
2017-09-08 Change the radial camera numbers to buttons. Then added a save/load functions so we can hold all the camera settings even though the UI only displays 1 of the cameras.
2017-09-08 Saved (and restored) camera/flash settings to flash on the esp8266. Also cleaned up how CA_LOG works since long strings were causing us to fall off the end of a buffer.
2017-09-08 CA_LOG was broken on sam3x. This fixes that.
    [UriHandler.ino]
2017-09-10 Change several http responces from GET to PUT. Fixes several erros in browser. Also fix dynamic menu restoring of checkbox to work correctly.
    [UriHandler.ino]
2017-09-10 Fix several ways that dynamic packet loading was broken in dynamic menus.
    [PacketProcessor.ino, UriHandler.ino]
2017-09-11 Fix a bug with slow trigger perf. The issue was we were incorrectly writing to flash too often
    [Esp8266.ino, UriHandler.ino, WifiSetup.ino, helper.ino]
2017-09-12 Make button react immedately and not get passed as part of the standard form submit. Stopped warning about missing elements.
    [PacketProcessor.ino]
2017-09-12 Change connection LEDs so they go back to red if disconnects
2017-09-13 Cleanup some menus and start adding code to handle camera/flash trigger timing
2017-09-14 Moved the smart preview check into the camera mode
2017-09-15 Get camera triggering working with real values. Fix timer code to match current units. Send interval and camera data on page refresh.
    [CA6.ino, Context.h, PacketProcessor.ino, Tests.ino, UriHandler.ino]
2017-09-16 Add code to handle the sequencer and mirror lockup modes in the camera settings menu
2017-09-17 Move dev board. Start sound board.
    [Dev-B.Cu.gbr, Dev-B.Mask.gbr, Dev-Edge.Cuts.gbr, Dev-F.Cu.gbr, Dev-F.Mask.gbr, Dev-F.SilkS.gbr, Dev-NPTH.drl, Dev.drl]
2017-09-18 Schematic for sound module
    [Sound.sch]
2017-09-19 Sound module pcb
    [Sound.dsn, Sound.kicad_pcb, _saved_Sound.sch]
2017-09-19 Valve schematic and pcb
    [Sound.sch, Valve.dsn, Valve.kicad_pcb, Valve.sch, _saved_Sound.sch]
2017-09-20 Update module pcbs to common format and fix issues.
    [Dev.dsn, Dev.kicad_pcb, Dev.sch, Sound.kicad_pcb, Template0.kicad_pcb, Valve.kicad_pcb, Valve.sch]
2017-09-21 Add Light module. This was done by Dan. I just had to merge it in manually because his branch had a bunch of conflicts.
    [Light.kicad_pcb, Light.sch]
2017-09-21 Add vibration module and fix reversed rj45 plug on dev sensor.
    [Dev.dsn, Dev.kicad_pcb, Vibration.kicad_pcb, Vibration.sch]
2017-09-22 Setup templates for new possible modules
    [IRConstant.kicad_pcb, IRConstant.sch, IRPulse.kicad_pcb, IRPulse.sch]
2017-09-22 Add info button to photo mode. Also adjusted the buttons in dynamic menu mode.
2017-09-23 Fix an issue with the analog tests causing failures when it shouldn't.
    [Tests.ino]
2017-09-24 Clean up trigger functions and fix bug where triggering when everything had 0 time caused nothing to ever trigger again before.
    [TriggerCam.ino]
2017-09-25 Implement set defaults button
2017-09-26 Clean up xmlHttpRequests with much better solution. Fix all known async timing issues.
    [UriHandler.ino]
2017-09-27 Add a simple button trigger to the test menu
2017-09-29 Optimize camera triggering. Delay between triggering cam0 and cam7 is reduced from 26 us to 120 ns (200x faster).
2017-09-29 Major cleanup on the camera triggering code. It's a little faster and several little issues fixed.
    [CA6.ino, Context.h, PacketProcessor.ino, TriggerCam.ino]
2017-10-05 Change the .ino files to .h. Needed to do this to prevent the Arduino magic which was getting in my way.
    [CA6.ino, Context.h, Esp8266.ino, Menus.h, PacketProcessor.h, Terminal.h, Tests.h, TriggerCam.h]
2017-10-09 Add a filtering class to assist in displaying values and fix lots of issues affecting the sound menu. Now this menu is working as expected.
    [CA6.ino, Esp8266.ino, Menus.h]
2017-10-10 Start adding valve menu
2017-10-11 Fix issues with Valve menu. Fix bug in digitalWrites and how it iteracts with new fast camera mode. Fix bug in webpage ordering.
    [Menus.h, Tests.h]
2017-10-11 Update dev module pcb
    [Dev.kicad_pcb, Dev.sch]
2017-10-11 Update sound module
    [Dev.sch, Sound.kicad_pcb, Sound.sch]
2017-10-11 Update vibration module pcb
    [Sound.kicad_pcb, Vibration.kicad_pcb, Vibration.sch]
2017-10-11 Remove template since it's out of date
    [Template0.kicad_pcb]
2017-10-12 Update Valve module
    [Sound.kicad_pcb, Valve.kicad_pcb, Valve.sch]
2017-10-15 Updated light module to new 2" x .8" board size with rounded corners. Updated pot to RK09K series (lower cost), corrected 10uF C1 footprint size to 1206, Added RK09K pot to CA6 footprint library.
    [Light.dsn, Light.kicad_pcb, Light.sch]
2017-10-15 Update dev pcb layout
    [Dev.kicad_pcb]
2017-10-16 Fix some issues with dev module and cleanup light module
    [Dev.sch, Light.kicad_pcb, Light.sch]
2017-10-16 Add hole to light sensor for mounting tube
    [Light.kicad_pcb]
2017-10-17 Update light module
    [Light.kicad_pcb]
2017-10-18 Add a button to clear wifi settings.
2017-10-18 Partial working - may need review & help. MenuRun seems to work correctly. PhotoRun display titles but not any of the values.
    [Menus.h]
2017-10-19 Change button port on dev module. Add functionality to enter esp8266 programming mode if dev module button pressed
    [Dev.sch]
2017-10-23 Fix bug in dev menu where it wouldn't return from photo mode. Fix bug in dummy menu with timebox
    [Menus.h]
2017-10-23 Fix wifi led to display correct colors and blink
    [WifiSetup.ino]
2017-10-24 Fixed a bug where if you write to USBSerial when it's not connected it hangs the system by checking for a connection. Also did several other pieces of cleanup.
    [CA6.ino, Esp8266.ino, PacketProcessor.h, PacketProcessor.ino, TriggerCam.h]
2017-10-24 1st version mostly working - text file with log including tick timer error & No Camera Triggered. rotating strike buffer indexing not correct. my light sensor values are jumping around a bit more tha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
    [Menus.h]
2017-10-25 Fix up PCB traces
    [Dev.kicad_pcb, Light.kicad_pcb, Sound.kicad_pcb, Valve.kicad_pcb, Valve.sch, Vibration.kicad_pcb]
2017-10-25 Change delay in mirror lockup to using interrupts.
2017-10-25 Started fixing lightning menu. Put in some missing statics to fix a bug where packets were being sent too often.
    [Menus.h, PacketProcessor.ino]
2017-10-26 Changed wifi led to blink faster. Simplified menu timing code by adding a helper function. Changed default camera duration to 200ms. Added a new file to put new menus in and added instructions for ad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
2017-10-26 Fixed indexing for strike details & cleaned up coding. Everything seems to be working.
    [Menus.h]
2017-10-30 Change camera port LEDs to 2 color LEDs Change to using vertical light pipes that stick into case instead of 90 degree light pipes that stick to PCB Completely reworked how camera triggering works to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
    [CA6.kicad_pcb, CA6.sch, CA6_0.kicad_pcb]
2017-10-30 Update pcb layout for modules
    [Dev.kicad_pcb, Sound.kicad_pcb, Vibration.kicad_pcb]
2017-11-01 Fix timing when using multiple valves
    [Menus.h]
2017-11-01 Add some 0.1uF caps
    [CA6.kicad_pcb, CA6.sch]
2017-11-05 Add schematics for beam and projectile modules
    [Beam.kicad_pcb, Beam.sch, IRConstant.kicad_pcb, IRConstant.sch, IRPulse.kicad_pcb, IRPulse.sch, Projectile.kicad_pcb, Projectile.sch]
2017-11-06 Pcb layout for beam and projectile module
    [Beam.kicad_pcb, Beam.sch, Projectile.kicad_pcb, Projectile.sch]
2017-11-06 Change 50 ohm resistor to 49.9
    [Projectile.kicad_pcb, Projectile.sch]
2017-11-07 Add a None to the list of camera, prefocus, smart_prefocus, and flash.
2017-11-07 Add a missing pullup resistor on the esp8266 programming circuit
    [CA6.kicad_pcb, CA6.sch]
2017-11-13 Fix missing wire on dev board and stop rounding corners on light pcb
    [Dev.kicad_pcb, Dev.sch, Light.kicad_pcb]
2017-11-16 Fixed valve menu to correctly offset camera/flash. This menu should be fully working now, but needs testing.
    [Menus.h, TriggerCam.h]
2017-11-19 Initial projectile menu for testing
    [Projectile.sch]
2017-11-30 Update pcbs
    [Beam.kicad_pcb, Beam.sch, Light.kicad_pcb, Light.sch]
2017-11-30 Temporarily modified the Light Menu to run a side-by-side test of original and new light sensor designs in a dynamic test, such as with a flash. Intend to get rid of these changes after design is don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
    [orig vs MOSFET light sensor-1.xlsx, orig vs MOSFET light sensor-sensH-tubeIN.xlsx, orig vs MOSFET light sensor-sensL-tubeIN.xlsx]
2017-12-01 Retested with corrected wiring; reduced to 500 points; ran both baseline and MOSFET tests
    [orig vs MOSFET light sensor-1.xlsx, orig vs MOSFET light sensor-sensH-tubeIN.xlsx, orig vs MOSFET light sensor-sensL-tubeIN.xlsx, orig vs new light sensor-sens-12-01.xlsx]
2017-12-01 Update beam sensor to seperate the emitter and detector
    [Beam.sch, BeamEmit.kicad_pcb, BeamEmit.sch]
2017-12-02 Changed menu.h - Light Menu to that needed for buffer chips on both sensitivity pins and tested,
    [orig vs new light sensor-sens-12-02-med-buffer.xlsx]
2017-12-02 Update module pcbs
    [Beam.kicad_pcb, Beam.sch, BeamEmit.kicad_pcb, BeamEmit.sch, Dev.sch, Projectile.sch, Sound.sch, Valve.sch]
2017-12-03 Rename pcbs and remove gerbers for cards which aren't used anymore
    [BeamDetect.kicad_pcb, BeamDetect.sch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]
2017-12-03 Update pcbs.
    [BeamDetect.kicad_pcb, BeamEmit.kicad_pcb, Dev.kicad_pcb, Projectile.kicad_pcb, Sound.kicad_pcb, Valve.kicad_pcb, Vibration.kicad_pcb]
2017-12-04 Updated the Schematic & PCB for the Light sensor to incorporate the new, auto-sensitivity circuit using two single-buffer chips and a resistor ladder instead of the pot. The Values of R4 and R5 might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
    [Light.dsn, Light.kicad_pcb, Light.sch]
2017-12-07 Update light pcb
    [Light.kicad_pcb, Light.sch]
2017-12-08 Update beam emitter to use single 20k
    [BeamEmit.kicad_pcb, BeamEmit.sch]
2017-12-10 Do an initial placement of the parts on the CA6 PCB
    [CA6.csv, CA6.kicad_pcb, CA6.sch]
2017-12-11 Corrected labels in CA6.sch in the ESP & CC section.
    [CA6.sch]
2017-12-11 Update light module to make PCB wider
    [Light.kicad_pcb, Light.sch]
2017-12-14 Add pulldown resistor to light module. Add laser off/on control to light menu
    [Light.kicad_pcb, Light.sch]
2017-12-14 Update wifi connection led
2017-12-15 Add CA6 voltage reading to advanced menu
2017-12-16 Update laser in light menu to work during menu mode
2017-12-18 Updated schematic for 4-resistor ladder with good values, and moved MOSFET to low (working) position. PCB only partially updated. Used a 3rd single buffer for now because I didn't see an exact equiva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
    [Light.kicad_pcb, Light.sch]
2017-12-18 Update PCBs to use n channel mosfet on low side
    [BeamDetect.kicad_pcb, Dev.kicad_pcb, Dev.sch, Light.kicad_pcb, Light.sch, Projectile.kicad_pcb, Projectile.sch, Vibration.kicad_pcb]
2017-12-19 Add framework so uint32 editbox values can be updated from menu code on sam3x. Will be helpful for some upcoming valve menu changes
2017-12-19 Updated light module for 3rd buffer and 4 resistors in the ladder, and updated resistor values to give a good change at each step. Todo: incorporate auto-sensitivity changes into Lightning Menu.
    [Light.kicad_pcb, Light.sch]
2017-12-19 Change 100K to 10K resistors
    [Projectile.kicad_pcb, Projectile.sch]
2017-12-19 Do light module pcb layout update
    [Light.kicad_pcb]
2017-12-20 Add more controls in photo mode on the valve menu. Including an auto calibrate mode
2017-12-22 Fix esp8266 layout and start routing
    [CA6.sch, CA6x.kicad_pcb]
2017-12-23 Update CA6 PCB. Also update versions of all the module pcbs to match.
    [BeamDetect.kicad_pcb, BeamEmit.kicad_pcb, CA6.kicad_pcb, Dev.kicad_pcb, Light.kicad_pcb, Projectile.kicad_pcb, Sound.kicad_pcb, Valve.kicad_pcb]
2017-12-24 Updated Lightning Menu to use auto sensitivity; updated Light Menu to use 4 sensitivity values; changed setLightSensitivity() to pass in values so that it can be shared with Lightning; updated #defin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
    [Esp8266.ino, Menus.h]
2017-12-26 Add Trigger Cams button in photo mode
2017-12-27 Fix bug in photo mode trigger cams button where prefocus wasn't handled correctly. Also added a feature to this button that it triggers flashes if you have toggled the button without a trigger event 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
    [TriggerCam.h]
2017-12-28 Update pcb silk screens
    [BeamDetect.kicad_pcb, Light.kicad_pcb]
2018-01-03 Start working on CA Flash schematic
    [CAFlash.kicad_pcb, CAFlash.sch]
2018-01-03 Work on led flash schematic
    [CAFlash.sch]
2018-01-04 Update schematic for led flash
    [CAFlash.sch]
2018-01-05 Update led flash schematic to add a few resistors to improve relibility
    [CAFlash.sch]
2018-01-06 Start filling out part footprints
    [CAFlash.sch]
2018-01-06 Add more footprints
    [CAFlash.sch]
2018-01-07 Start pcb layout
    [CAFlash.sch]
2018-01-08 Start working on spice simulation
    [CAFlash.sch]
2018-01-09 Update schematic and finish spice model
    [CAFlash.kicad_pcb, CAFlash.sch]
2018-01-10 Check in an initial pcb layout
    [CAFlash.kicad_pcb, CAFlash.sch]
2018-01-10 Fix merge issues
    [CAFlash.kicad_pcb, CAFlash.sch]
2018-01-10 Update pcb layout
    [CAFlash.kicad_pcb]
2018-01-10 Fix silkscreen on pcb. Update gerbers. Cleanup webpage a little.
    [CA6-B.Cu.gbl, CA6-B.Mask.gbs, CA6-Edge.Cuts.gm1, CA6-F.Cu.gtl, CA6-F.Mask.gts, CA6-F.Paste.gtp, CA6-F.SilkS.gto, CA6-NPTH.drl]
2018-01-10 Add LED to spice model and add gerbers for modules.
    [BeamDetect-B.Cu.gbr, BeamDetect-B.Mask.gbr, BeamDetect-B.Paste.gbr, BeamDetect-B.SilkS.gbr, BeamDetect-Edge.Cuts.gbr, BeamDetect-F.Cu.gbr, BeamDetect-F.Mask.gbr, BeamDetect-F.Paste.gbr]
2018-01-11 Fix 3 issues pcba house found in pcb. Update spice files.
    [CA6-B.Cu.gbl, CA6-B.Mask.gbs, CA6-B.SilkS.gbo, CA6-Edge.Cuts.gm1, CA6-F.Cu.gtl, CA6-F.Mask.gts, CA6-F.Paste.gtp, CA6-F.SilkS.gto]
2018-01-11 Update spice model and fix bug in pcb.
    [CAFlash.kicad_pcb, CAFlash.sch]
2018-01-13 Large change to how ajax packets are sent. This put in the framework to sent multiple data pieces and get multiple returns. It is currently used in a few places, but I need to go and use this functio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
    [Menus.h, UriHandler.ino, helper.ino]
2018-01-15 Update CA Flash to include logo. Start work on laser cut cases for modules
    [CAFlash.kicad_pcb, CAFlash.sch]
2018-01-15 Laser cut case files for modules
2018-01-16 Fixed formatting of strike details by using the <pre> tag and spaces; removed microseconds from strike duration (and code); didn't have time to merge with master code, and still have Cam/Flash 6 soli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
    [Menus.h]
2018-01-16 Added tripod mount holes to module cases. Updated flash schematic to use a bigger current sense resistor after doing some calculations. Updated spice file for new resistor.
    [_saved_CAFlash.sch]
2018-01-16 Missing schematic changes from previous submit
    [CAFlash.sch, _saved_CAFlash.sch]
2018-01-17 Stop sending packets for projectile menu too often. Clear out the dynamic message string when switching menus
2018-01-18 Fix delays in lightning and projectile menus that were leading to packet corruption. Update javascript to fix bug in number validation.
    [Menus.h]
2018-01-19 Fix logging. Improve comments. Fix compiler warnings.
    [CA6.ino, Context.h, Esp8266.ino, MenuData.h, Menus.h, NewMenu.h, PacketProcessor.h, PacketProcessor.ino]
2018-01-24 Fixed a few things but getting errors in other parts of the code. Commit to go back to master and check.
    [Menus.h]
2018-01-24 Fixed all warnings - clean compile. However, still have cam6 port bug. Still looking into it.
    [Menus.h]
2018-01-25 Some code cleanup and comments while looking for cam6 issue. Issue not found. Testing results reported in forum. Lightning menu is working but with cam6 issue.
    [Menus.h]
2018-01-25 Fix bug in lightning menu with uninitalized structures. Fix bug in how mirror lockup checkbox was read on webpage.
    [Menus.h]
2018-01-26 Add some missing text to silkscreen. Move mount holes by 5 mils.
    [Projectile.kicad_pcb]
2018-01-27 Fix bug in digital reads/writes. Update code now that hardware is back.
    [CAFlash.ino]
2018-01-28 Add PWM code to led flash. Update spice model with more options.
2018-01-29 Update flash firmware so it can do an initial test using pwm. I have done a test with this version and it worked, but some changes are needed
2018-01-30 Corrected garbage characters at start of PhotoMode -- error was modulo 5 with count <= 0. May still rework code to pull LTGDisplayPhotoMode() inline and remove several variables from the LightningDat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
    [Menus.h]
2018-01-31 Update flash software
    [CAFlash.sch]
2018-02-02 Start work on the 24 LED version of the PCB. Removed some extra stuff from the test pcb and.
    [CAFlash.kicad_pcb, CAFlash.sch]
2018-02-03 Finish layout of the 24 led version of the led flash
    [CAFlash-B.Cu.gbr, CAFlash-B.Mask.gbr, CAFlash-B.Paste.gbr, CAFlash-B.SilkS.gbr, CAFlash-Edge.Cuts.gbr, CAFlash-F.Cu.gbr, CAFlash-F.Mask.gbr, CAFlash-F.Paste.gbr]
2018-02-04 Start work on code to transfer data to led flash. Update pcb to improve clearance.
    [CAFlash.kicad_pcb]
2018-02-05 Finish code to transfer data to led flash. Update PCB to have pullup resistors on ring/tip pins so I can adjust these instead of just using the internal pullup
    [CAFlash.kicad_pcb, CAFlash.sch]
2018-02-06 Add updated gerber files and switch firmware back to functioning version.
    [CAFlash-B.Cu.gbr, CAFlash-B.Mask.gbr, CAFlash-B.Paste.gbr, CAFlash-B.SilkS.gbr, CAFlash-Edge.Cuts.gbr, CAFlash-F.Cu.gbr, CAFlash-F.Mask.gbr, CAFlash-F.Paste.gbr]
2018-02-07 Start using free running mode on the adc
2018-02-08 Add new pwm for next pcb (not used or tested yet). Update pcb to add diode that prevents charging cap through ftdi 5v
    [CAFlash.kicad_pcb, CAFlash.sch]
2018-02-09 Update silk screen on led flash pcb.
    [CAFlash.kicad_pcb]
2018-03-04 Work on next version of led flash
    [CAFlash.kicad_pcb, CAFlash.sch]
2018-03-04 Cleanup layout
    [CAFlash.kicad_pcb]
2018-03-05 Add smaller cap
    [CAFlash.kicad_pcb, CAFlash.sch]
2018-03-08 Increase LEDs from 25 to 36
    [CAFlash.kicad_pcb, CAFlash.sch]
2018-03-08 Add gerber files to led flash
    [CAFlash-B.Cu.gbr, CAFlash-B.Mask.gbr, CAFlash-B.Paste.gbr, CAFlash-B.SilkS.gbr, CAFlash-Edge.Cuts.gbr, CAFlash-F.Cu.gbr, CAFlash-F.Mask.gbr, CAFlash-F.Paste.gbr]
2018-03-26 Update laser module cases
2018-03-28 Update for new PCB. Fix some bugs for unit tests, loading new programs onto esp8266, and other minor things.
    [CA6.ino, Tests.h, TriggerCam.h]
2018-03-29 Clean up memory leak issue
    [Esp8266.ino]
2018-04-01 With the new pcb the cam port structures don't need to track all 4 ports. Instead they all use port b. This is faster and saves 672 bytes of ram.
2018-04-02 Move holes on sound module to match other modules. Updated silkscreens on other modules. Generate gerbers
    [BeamEmit.kicad_pcb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]
2018-05-31 Update minor things
    [Light.kicad_pcb]
2018-06-06 Change testing to always be built in and to run if the aux dongle connected and program button is pressed
2018-06-12 Add test jig
    [CA6Test-B.Cu.gbl, CA6Test-B.Mask.gbs, CA6Test-B.SilkS.gbo, CA6Test-Edge.Cuts.gm1, CA6Test-F.Cu.gtl, CA6Test-F.Mask.gts, CA6Test-F.Paste.gtp, CA6Test-F.SilkS.gto]
2018-06-28 Update module pcbs to fix minor issues and round corners
    [BeamDetect-B.Cu.gbr, BeamDetect-B.Mask.gbr, BeamDetect-B.Paste.gbr, BeamDetect-B.SilkS.gbr, BeamDetect-Edge.Cuts.gbr, BeamDetect-F.Cu.gbr, BeamDetect-F.Mask.gbr, BeamDetect-F.Paste.gbr]
2018-06-28 Move silkscreen on light module
    [Light-B.Cu.gbl, Light-B.Mask.gbs, Light-B.Paste.gbp, Light-B.SilkS.gbo, Light-Edge.Cuts.gm1, Light-F.Cu.gtl, Light-F.Mask.gts, Light-F.Paste.gtp]
2018-07-19 Fix hang when exiting lightning menu to home. Issue was that an analog read was happening after resetting the ports.
    [Menus.h]
2018-07-20 Fix bug with passing values back to javascript from esp8266. This was preventing valve module changes made in photo mode from being saved in the menu.
2018-07-20 Instead of adding a minium post trigger delay when using the valve menu (which is easy if I want to do it later) I decided to just add a note to the valve menu reminding users to set that setting the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
2019-04-03 Update pcb for new switch
    [BeamDetect-2019-01-15-18-56-07.sch, BeamDetect.sch, BeamEmit-2019-01-15-18-57-28.sch, BeamEmit.sch, CA6-2019-01-10-17-11-17.sch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]
2019-04-10 Add case files and missing BOMs
    [BOM_beamDetect.xlsx, BOM_beamEmit.xlsx, BOM_ca6.xlsx, BOM_dev.xlsx, BOM_light.xlsx, BOM_projectile.xlsx, BOM_sound.xlsx, BOM_valve.xlsx]
2019-05-30 Update pcb
